yuqlid/EtherCAT_shield_v1/README.md

# EtherCAT_shield_v1
Nuleo64 EtherCAT Board

This board connect Nucleo64 to EtherCAT with LAN9252 controller chip.

Target Nucleo64 board
- NUCLEO-L476RG http://www.st.com/ja/evaluation-tools/nucleo-l476rg.html
- NUCLEO-F446RE http://www.st.com/ja/evaluation-tools/nucleo-f446re.html
