yuqlid/EtherCAT_shield_v1/EtherCAT_shield_v1.xlsx

Reference | Value | Footprint | Datasheet
R3 | 0 | Resistors_SMD:R_0603 | http://akizukidenshi.com/catalog/g/gR-11619/
R6 | 0 | Resistors_SMD:R_0603
R17 | 49.9 | Resistors_SMD:R_0603 | https://www.digikey.jp/product-detail/ja/yageo/RC0603FR-0749R9L/311-49.9HRCT-ND/730211
R16 | 49.9 | Resistors_SMD:R_0603
R15 | 49.9 | Resistors_SMD:R_0603
R14 | 49.9 | Resistors_SMD:R_0603
R11 | 49.9 | Resistors_SMD:R_0603
R10 | 49.9 | Resistors_SMD:R_0603
R9 | 49.9 | Resistors_SMD:R_0603
R8 | 49.9 | Resistors_SMD:R_0603
R5 | 330 | Resistors_SMD:R_0603 | https://www.digikey.jp/product-detail/ja/yageo/RC0603FR-07330RL/311-330HRCT-ND/730109 |  | 多分1kとかでもいい
R7 | 330 | Resistors_SMD:R_0603 |  |  | 多分1kとかでもいい
R22 | 330 | Resistors_SMD:R_0603 |  |  | 多分1kとかでもいい
R23 | 330 | Resistors_SMD:R_0603 |  |  | 多分1kとかでもいい
C2 | 0.022u | Capacitors_SMD:C_0603 | https://www.digikey.jp/product-detail/ja/samsung-electro-mechanics-america-inc/CL10B223KB8NNNC/1276-1104-1-ND/3889190
C3 | 0.022u | Capacitors_SMD:C_0603
C1 | 0.1u | Capacitors_SMD:C_0603 | http://akizukidenshi.com/catalog/g/gP-04940/
C18 | 0.1u | Capacitors_SMD:C_0603
C16 | 0.1u | Capacitors_SMD:C_0603
C4 | 0.1u | Capacitors_SMD:C_0603
C11 | 0.1u | Capacitors_SMD:C_0603
C17 | 0.1u | Capacitors_SMD:C_0603
C14 | 0.1u | Capacitors_SMD:C_0603
C15 | 0.1u | Capacitors_SMD:C_0603
C5 | 0.1u | Capacitors_SMD:C_0603
C6 | 0.1u | Capacitors_SMD:C_0603
C7 | 0.1u | Capacitors_SMD:C_0603
C8 | 0.1u | Capacitors_SMD:C_0603
C9 | 0.1u | Capacitors_SMD:C_0603
C10 | 0.1u | Capacitors_SMD:C_0603
C25 | 0.1u | Capacitors_SMD:C_0603
R4 | 10k | Resistors_SMD:R_0603 | 部室
R12 | 10k | Resistors_SMD:R_0603
R21 | 10k | Resistors_SMD:R_0603
R18 | 10k | Resistors_SMD:R_0603
R42 | 10k | Resistors_SMD:R_0603
R43 | 10k | Resistors_SMD:R_0603
R44 | 10k | Resistors_SMD:R_0603
C21 | 10p | Capacitors_SMD:C_0603 | https://www.digikey.jp/product-detail/ja/kemet/C0603C100J5GACTU/399-1049-1-ND/411324
C22 | 10p | Capacitors_SMD:C_0603
C23 | 10p | Capacitors_SMD:C_0603
C24 | 10p | Capacitors_SMD:C_0603
C26 | 10p | Capacitors_SMD:C_0603
C27 | 10p | Capacitors_SMD:C_0603
C28 | 10p | Capacitors_SMD:C_0603
C29 | 10p | Capacitors_SMD:C_0603
C31 | 10u | Capacitors_SMD:C_0805 | http://akizukidenshi.com/catalog/g/gP-07388/
C30 | 10u | Capacitors_SMD:C_0805
C33 | 10u | Capacitors_SMD:C_0805
C32 | 10u | Capacitors_SMD:C_0805
R13 | 12.1k | Resistors_SMD:R_0603 | https://www.digikey.jp/product-detail/ja/yageo/RC0603FR-0712K1L/311-12.1KHRCT-ND/729862
R24 | 1k | Resistors_SMD:R_0603 | https://www.digikey.jp/product-detail/ja/yageo/RC0603JR-071KL/311-1.0KGRCT-ND/729624
R25 | 1k | Resistors_SMD:R_0603
R26 | 1k | Resistors_SMD:R_0603
R27 | 1k | Resistors_SMD:R_0603
R28 | 1k | Resistors_SMD:R_0603
R29 | 1k | Resistors_SMD:R_0603
R30 | 1k | Resistors_SMD:R_0603
R31 | 1k | Resistors_SMD:R_0603
R32 | 1k | Resistors_SMD:R_0603
R33 | 1k | Resistors_SMD:R_0603
R34 | 1k | Resistors_SMD:R_0603
R35 | 1k | Resistors_SMD:R_0603
R36 | 1k | Resistors_SMD:R_0603
R37 | 1k | Resistors_SMD:R_0603
R38 | 1k | Resistors_SMD:R_0603
R39 | 1k | Resistors_SMD:R_0603
C12 | 1u | Capacitors_SMD:C_0603 | http://akizukidenshi.com/catalog/g/gP-09633/
U2 | 24LC00 | Housings_DIP:DIP-8_W7.62mm_Socket_LongPads | http://akizukidenshi.com/catalog/g/gI-03569/ | http://akizukidenshi.com/catalog/g/gP-00035/
R19 | 2k | Resistors_SMD:R_0603 |  |  | 多分4.7kとかでもいい
R20 | 2k | Resistors_SMD:R_0603 |  |  | 多分4.7kとかでもいい
R45 | 4.7k | Resistors_SMD:R_0603 |  |  | 多分10kとかでもいい
C13 | 470p | Capacitors_SMD:C_0603 | https://www.digikey.jp/product-detail/ja/samsung-electro-mechanics-america-inc/CL10C471JB8NNNC/1276-1168-1-ND/3889254 | http://akizukidenshi.com/catalog/g/gP-09268/
C19 | C | Capacitors_SMD:C_0603 | https://www.digikey.jp/product-detail/ja/kemet/C0603C100J5GACTU/399-1049-1-ND/411324
C20 | C | Capacitors_SMD:C_0603
P1 | CONN_02X10 | Socket_Strips:Socket_Strip_Straight_2x10_Pitch2.54mm | http://akizukidenshi.com/catalog/g/gC-00083/
P2 | CONN_02X19 | Pin_Headers:Pin_Header_Straight_2x19_Pitch2.54mm | http://www.digikey.jp/product-detail/ja/samtec-inc/ESQ-119-24-T-D/SAM9313-ND/6678050 |  | たっか，なんか他のでどうにかしたい
P3 | CONN_02X19 | Pin_Headers:Pin_Header_Straight_2x19_Pitch2.54mm
Y1 | Crystal_GND24 | Crystals:Crystal_SMD_Abracon_ABM8G-4pin_3.2x2.5mm | https://www.digikey.jp/product-detail/ja/abracon-llc/ABM8-25.000MHZ-10-D1G-T/535-13468-1-ND/5980144
J7 | GS2 | Connect:GS2
J8 | GS2 | Connect:GS2
J5 | GS3 | Connect:GS3
J6 | GS3 | Connect:GS3
J4 | GS3 | Connect:GS3
J3 | GS3 | Connect:GS3
L4 | L | Capacitors_SMD:C_0603 | https://www.digikey.jp/products/ja?keywords=%09490-5255-1-ND
L1 | L | Capacitors_SMD:C_0603
L2 | L | Capacitors_SMD:C_0603
L3 | L | Capacitors_SMD:C_0603
U1 | LAN9252 | Housings_DFN_QFN:QFN-64-1EP_9x9mm_Pitch0.5mm | https://www.digikey.jp/product-detail/ja/microchip-technology/LAN9252-ML/LAN9252-ML-ND/5252338
D1 | LED | LEDs:LED_0603 | http://akizukidenshi.com/catalog/g/gI-03980/
D2 | LED | LEDs:LED_0603
D3 | LED | LEDs:LED_0603
D4 | LED | LEDs:LED_0603
D5 | LED | LEDs:LED_0603
D6 | LED | LEDs:LED_0603
D7 | LED | LEDs:LED_0603
D8 | LED | LEDs:LED_0603
D9 | LED | LEDs:LED_0603
D10 | LED | LEDs:LED_0603
D11 | LED | LEDs:LED_0603
D12 | LED | LEDs:LED_0603
D13 | LED | LEDs:LED_0603
D14 | LED | LEDs:LED_0603
D15 | LED | LEDs:LED_0603
D16 | LED | LEDs:LED_0603
D17 | LED | LEDs:LED_0603
D18 | LED | LEDs:LED_0603
R1 | R | Resistors_SMD:R_0603 |  |  | 多分1kとかでもいい
R2 | R | Resistors_SMD:R_0603 |  |  | 多分1kとかでもいい
R40 | R | Resistors_SMD:R_1210
R41 | R | Resistors_SMD:R_1210
J2 | RJ45-PULSETRANS | Connect:RJ45_J0011D21BNL | http://akizukidenshi.com/catalog/g/gP-04809/ | http://akizukidenshi.com/catalog/g/gP-00819/
J1 | RJ45-PULSETRANS | Connect:RJ45_J0011D21BNL
