yuqlid/EtherCAT_shield_v1/EtherCAT_shield_v1.pdf

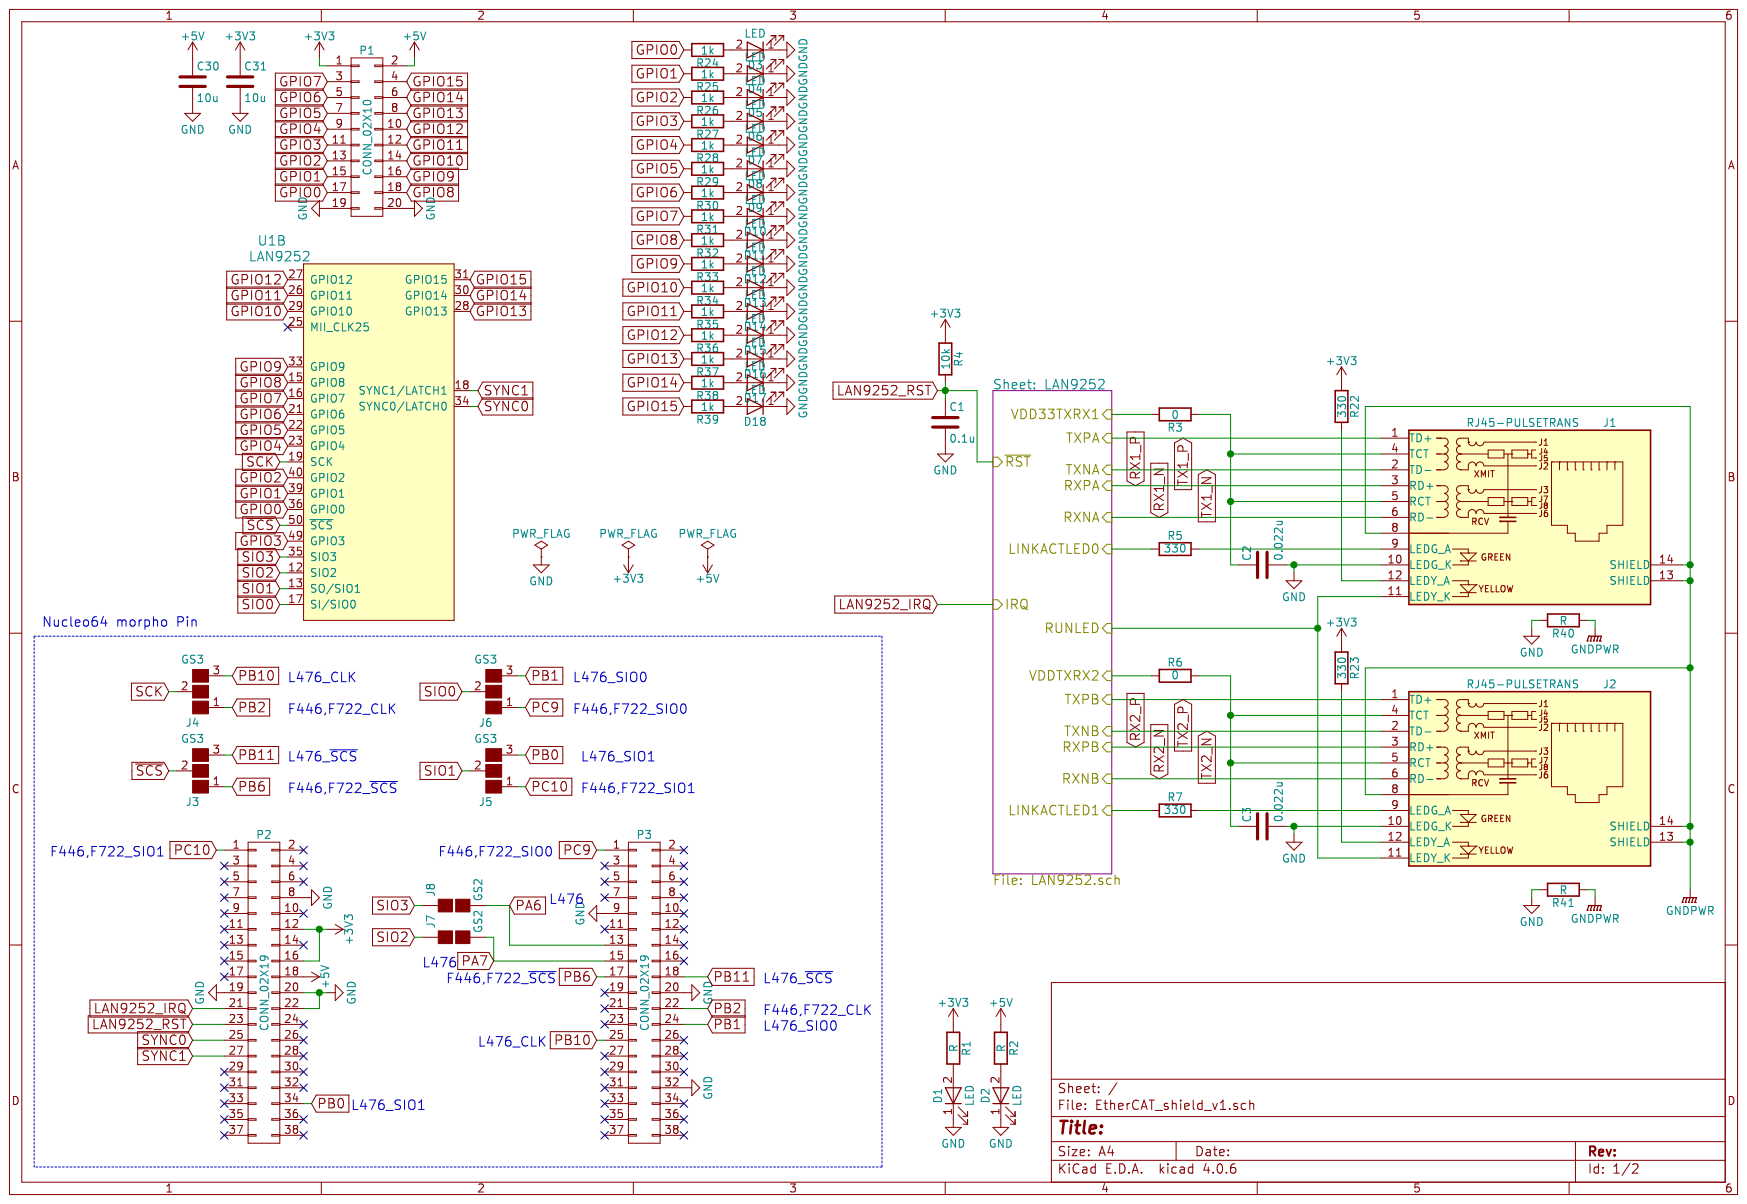
[picture p1: page 1]

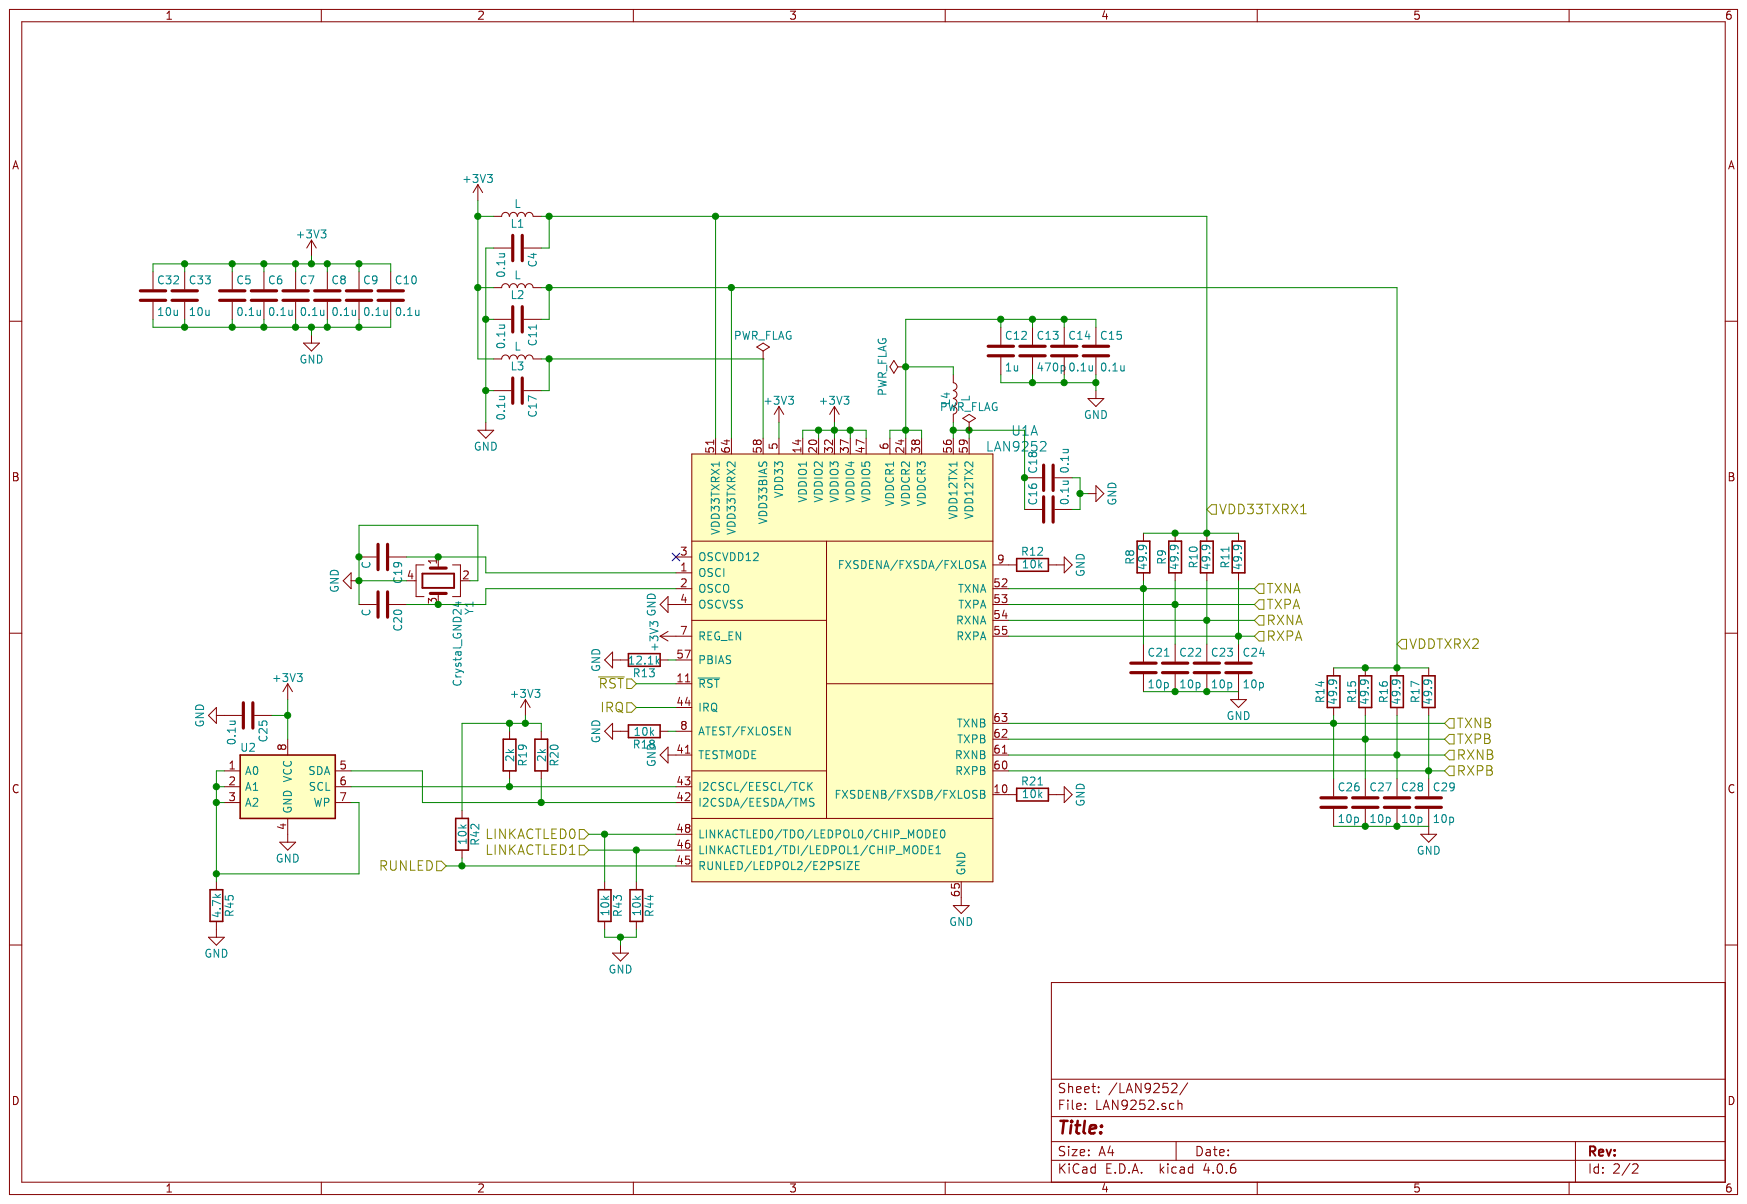
[picture p2: page 2]
