yuqlid/EtherCAT_shield_v1/EtherCAT_shield_v1.kicad_pcb

## KiCad design EtherCAT_shield_v1.kicad_pcb (2017-06-03)

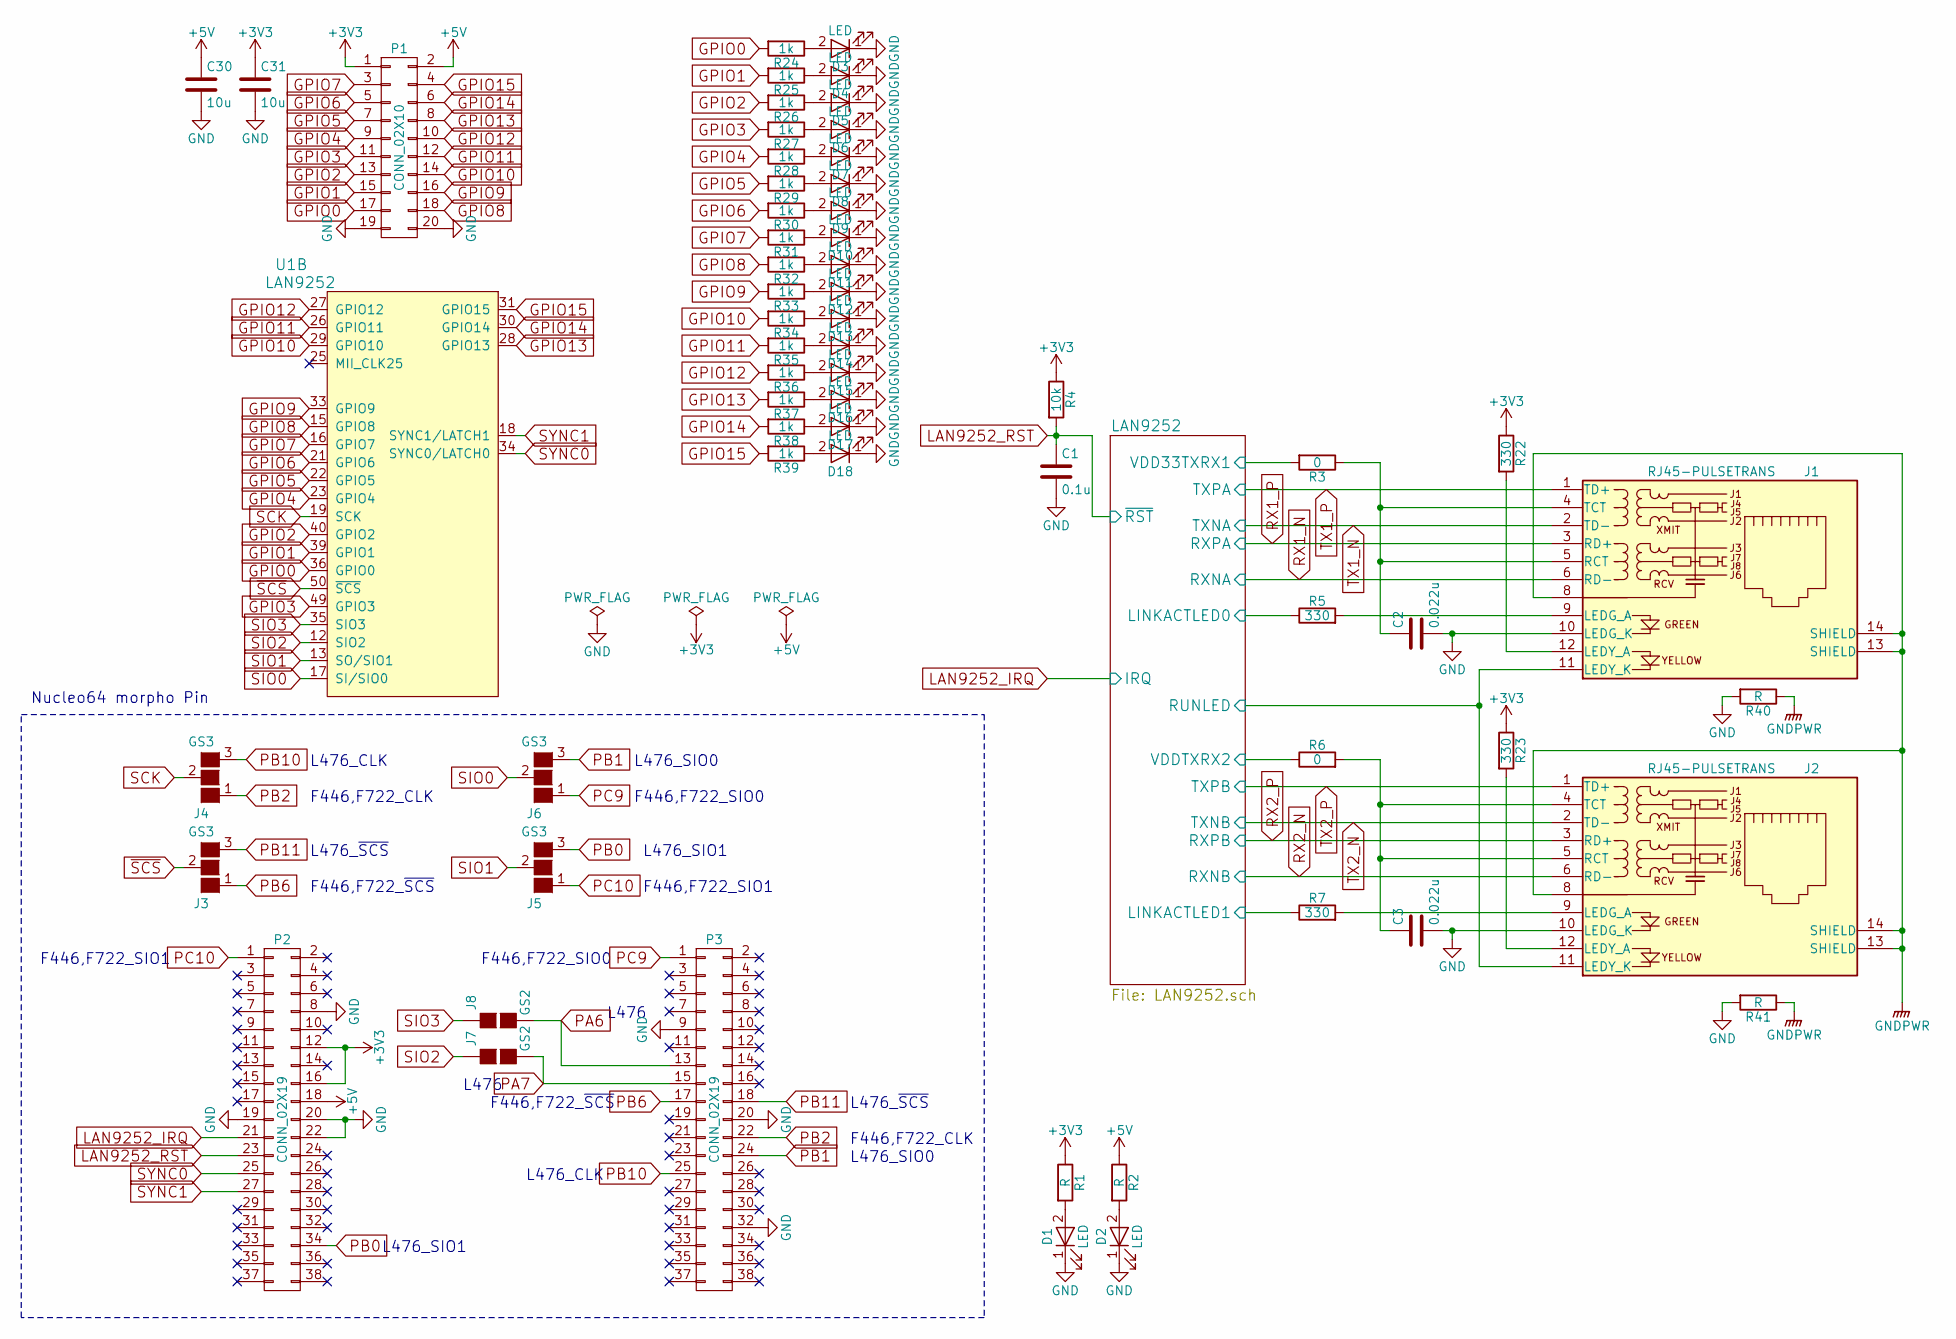
[picture p3: schematic EtherCAT_shield_v1.sch]

Parts:
C1: 0.1u; C_0603
C2, C3: 0.022u; C_0603
C30, C31: 10u; C_0805
D1, D2, D3, D4, D5, D6, D7, D8, D9, D10, D11, D12, D13, D14, D15, D16, D17, D18: LED; LED_0603
J1, J2: RJ45-PULSETRANS; RJ45_J0011D21BNL
J3, J4, J5, J6: GS3
J7, J8: GS2
P1: CONN_02X10; Socket_Strip_Straight_2x10_Pitch2.54mm
P2, P3: CONN_02X19; Pin_Header_Straight_2x19_Pitch2.54mm
R1, R2: R; R_0603
R3, R6: 0; R_0603
R4: 10k; R_0603
R5, R7, R22, R23: 330; R_0603
R24, R25, R26, R27, R28, R29, R30, R31, R32, R33, R34, R35, R36, R37, R38, R39: 1k; R_0603
R40, R41: R; R_1210
U1: LAN9252; QFN-64-1EP_9x9mm_Pitch0.5mm

Connections:
+3V3: C31.1, P1.1, P2.12, P2.16, R1.1, R4.1, R22.1, R23.1; also elsewhere on the board
+5V: C30.1, P1.2, P2.18, R2.1
/LAN9252/LINKACTLED0: R5.1; also elsewhere on the board
/LAN9252/LINKACTLED1: R7.1; also elsewhere on the board
/LAN9252/RUNLED: J1.11 (LEDY_K), J2.11 (LEDY_K); also elsewhere on the board
/LAN9252/VDD33TXRX1: R3.2; also elsewhere on the board
/LAN9252/VDDTXRX2: R6.1; also elsewhere on the board
GND: C1.2, C2.2, C3.2, C30.2, C31.2, D1.1 (K), D2.1 (K), D3.1 (K), D4.1 (K), D5.1 (K), D6.1 (K), D7.1 (K), D8.1 (K), D9.1 (K), D10.1 (K), D11.1 (K), D12.1 (K), D13.1 (K), D14.1 (K), D15.1 (K), D16.1 (K), D17.1 (K), D18.1 (K), J1.10 (LEDG_K), J2.10 (LEDG_K), P1.19, P1.20, P2.8, P2.19, P2.20, P2.22, P3.9, P3.20, P3.32, R40.2, R41.2; also elsewhere on the board
GNDPWR: J1.8, J1.13 (SHIELD), J1.14 (SHIELD), J2.8, J2.13 (SHIELD), J2.14 (SHIELD), R40.1, R41.1
GPIO0: P1.17, R24.2, U1.36 (GPIO0)
GPIO1: P1.15, R25.2, U1.39 (GPIO1)
GPIO2: P1.13, R26.2, U1.40 (GPIO2)
GPIO3: P1.11, R27.2, U1.49 (GPIO3)
GPIO4: P1.9, R28.2, U1.23 (GPIO4)
GPIO5: P1.7, R29.2, U1.22 (GPIO5)
GPIO6: P1.5, R30.2, U1.21 (GPIO6)
GPIO7: P1.3, R31.2, U1.16 (GPIO7)
GPIO8: P1.18, R32.2, U1.15 (GPIO8)
GPIO9: P1.16, R33.2, U1.33 (GPIO9)
GPIO10: P1.14, R34.2, U1.29 (GPIO10)
GPIO11: P1.12, R35.2, U1.26 (GPIO11)
GPIO12: P1.10, R36.2, U1.27 (GPIO12)
GPIO13: P1.8, R37.2, U1.28 (GPIO13)
GPIO14: P1.6, R38.2, U1.30 (GPIO14)
GPIO15: P1.4, R39.2, U1.31 (GPIO15)
LAN9252_IRQ: P2.21; also elsewhere on the board
LAN9252_RST: C1.1, P2.23, R4.2; also elsewhere on the board
unnamed: C2.1, J1.4 (TCT), J1.5 (RCT), R3.1
unnamed: C3.1, J2.4 (TCT), J2.5 (RCT), R6.2
unnamed: D1.2 (A), R1.2
unnamed: D2.2 (A), R2.2
unnamed: D3.2 (A), R24.1
unnamed: D4.2 (A), R25.1
unnamed: D5.2 (A), R26.1
unnamed: D6.2 (A), R27.1
unnamed: D7.2 (A), R28.1
unnamed: D8.2 (A), R29.1
unnamed: D9.2 (A), R30.1
unnamed: D10.2 (A), R31.1
unnamed: D11.2 (A), R32.1
unnamed: D12.2 (A), R33.1
unnamed: D13.2 (A), R34.1
unnamed: D14.2 (A), R35.1
unnamed: D15.2 (A), R36.1
unnamed: D16.2 (A), R37.1
unnamed: D17.2 (A), R38.1
unnamed: D18.2 (A), R39.1
unnamed: J1.9 (LEDG_A), R5.2
unnamed: J1.12 (LEDY_A), R22.2
unnamed: J2.9 (LEDG_A), R7.2
unnamed: J2.12 (LEDY_A), R23.2
PA6: J8.2 (G2), P3.13
PA7: J7.2 (G2), P3.15
PB0: J5.3 (G3), P2.34
PB1: J6.3 (G3), P3.24
PB2: J4.1 (G1), P3.22
PB6: J3.1 (G1), P3.17
PB10: J4.3 (G3), P3.25
PB11: J3.3 (G3), P3.18
PC9: J6.1 (G1), P3.1
PC10: J5.1 (G1), P2.1
RX1_N: J1.6 (RD-); also elsewhere on the board
RX1_P: J1.3 (RD+); also elsewhere on the board
RX2_N: J2.6 (RD-); also elsewhere on the board
RX2_P: J2.3 (RD+); also elsewhere on the board
SCK: J4.2 (G2), U1.19 (SCK)
SIO0: J6.2 (G2), U1.17 (SI/SIO0)
SIO1: J5.2 (G2), U1.13 (SO/SIO1)
SIO2: J7.1 (G1), U1.12 (SIO2)
SIO3: J8.1 (G1), U1.35 (SIO3)
SYNC0: P2.25, U1.34 (SYNC0/LATCH0)
SYNC1: P2.27, U1.18 (SYNC1/LATCH1)
TX1_N: J1.2 (TD-); also elsewhere on the board
TX1_P: J1.1 (TD+); also elsewhere on the board
TX2_N: J2.2 (TD-); also elsewhere on the board
TX2_P: J2.1 (TD+); also elsewhere on the board
~SCS: J3.2 (G2), U1.50 (~SCS)

Notes on the sheet:
F446,F722_~SCS
L476_CLK
L476
L476_SIO1
F446,F722_SIO1
F446,F722_CLK
L476_~SCS
L476_SIO0
F446,F722_SIO0
Nucleo64 morpho Pin

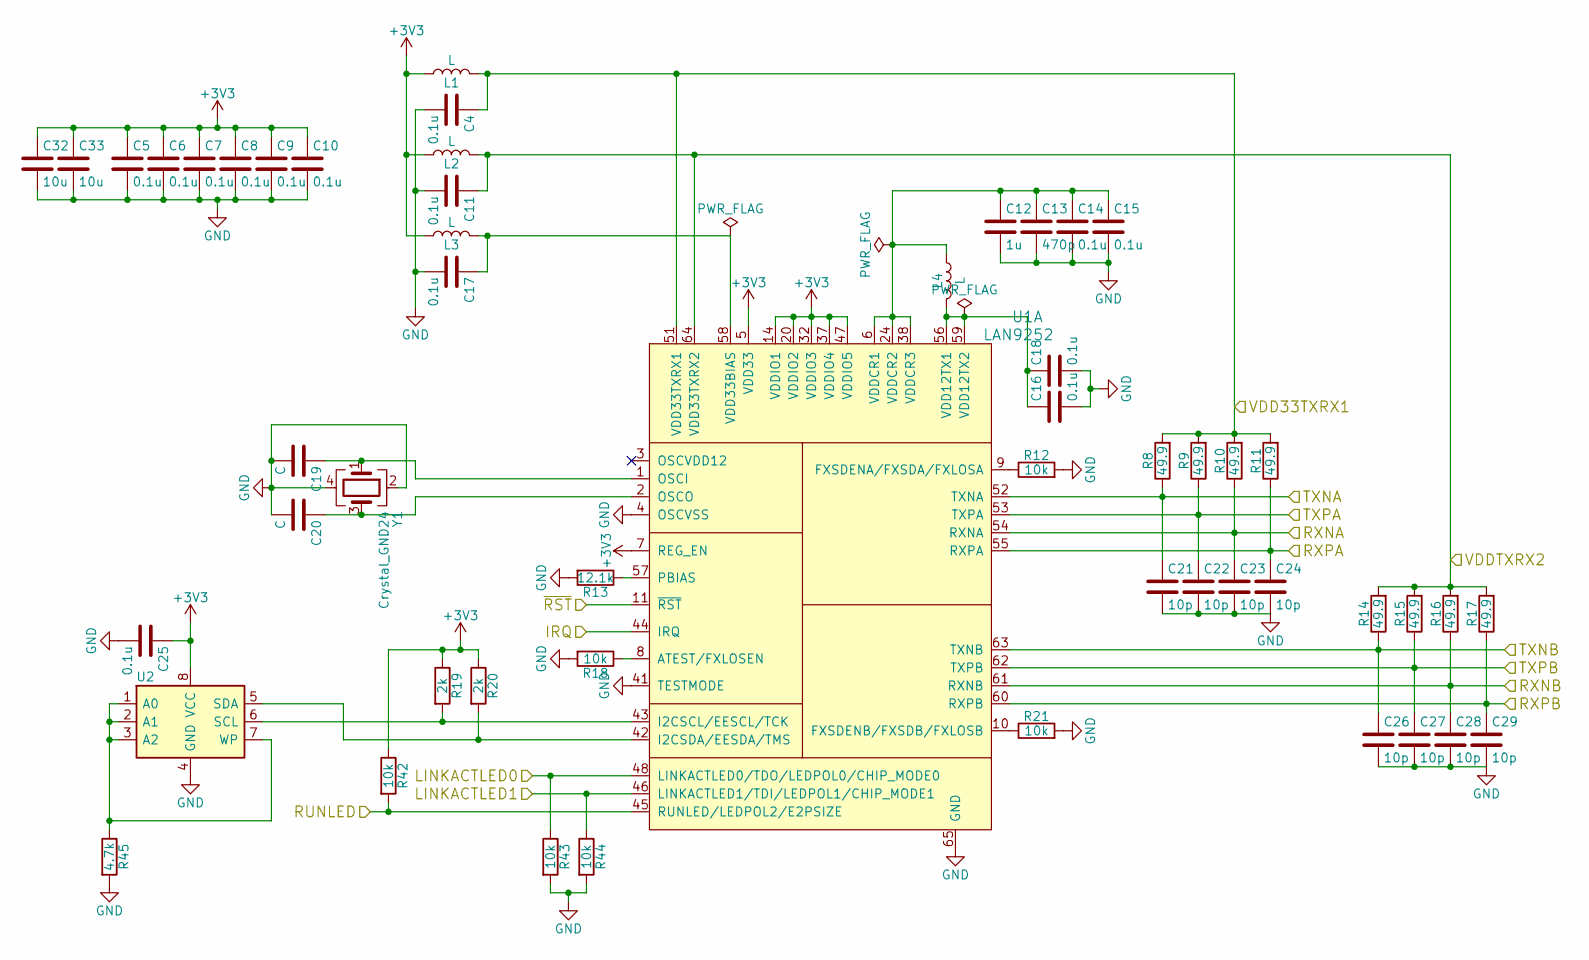
[picture p4: schematic LAN9252.sch]

Parts:
C4, C5, C6, C7, C8, C9, C10, C11, C14, C15, C16, C17, C18, C25: 0.1u; C_0603
C12: 1u; C_0603
C13: 470p; C_0603
C19, C20: C; C_0603
C21, C22, C23, C24, C26, C27, C28, C29: 10p; C_0603
C32, C33: 10u; C_0805
L1, L2, L3, L4: L; C_0603
R8, R9, R10, R11, R14, R15, R16, R17: 49.9; R_0603
R12, R18, R21, R42, R43, R44: 10k; R_0603
R13: 12.1k; R_0603
R19, R20: 2k; R_0603
R45: 4.7k; R_0603
U1: LAN9252; QFN-64-1EP_9x9mm_Pitch0.5mm
U2: 24LC00; DIP-8_W7.62mm_Socket_LongPads
Y1: Crystal_GND24; Crystal_SMD_Abracon_ABM8G-4pin_3.2x2.5mm

Connections:
+3V3: C5.1, C6.1, C7.1, C8.1, C9.1, C10.1, C25.1, C32.1, C33.1, L1.1, L2.1, L3.1, R19.1, R20.1, R42.1, U1.5 (VDD33), U1.7 (REG_EN), U1.14 (VDDIO1), U1.20 (VDDIO2), U1.32 (VDDIO3), U1.37 (VDDIO4), U1.47 (VDDIO5), U2.8 (VCC); also elsewhere on the board
/LAN9252/LINKACTLED0: R43.1, U1.48 (LINKACTLED0/TDO/LEDPOL0/CHIP_MODE0); also elsewhere on the board
/LAN9252/LINKACTLED1: R44.1, U1.46 (LINKACTLED1/TDI/LEDPOL1/CHIP_MODE1); also elsewhere on the board
/LAN9252/RUNLED: R42.2, U1.45 (RUNLED/LEDPOL2/E2PSIZE); also elsewhere on the board
/LAN9252/VDD33TXRX1: C4.1, L1.2, R8.2, R9.2, R10.2, R11.2, U1.51 (VDD33TXRX1); also elsewhere on the board
/LAN9252/VDDTXRX2: C11.1, L2.2, R14.2, R15.2, R16.2, R17.2, U1.64 (VDD33TXRX2); also elsewhere on the board
GND: C4.2, C5.2, C6.2, C7.2, C8.2, C9.2, C10.2, C11.2, C12.2, C13.2, C14.2, C15.2, C16.2, C17.2, C18.2, C19.2, C20.2, C21.2, C22.2, C23.2, C24.2, C25.2, C26.2, C27.2, C28.2, C29.2, C32.2, C33.2, R12.2, R13.2, R18.2, R21.2, R43.2, R44.2, R45.2, U1.4 (OSCVSS), U1.41 (TESTMODE), U1.65 (GND), U2.4 (GND), Y1.2, Y1.4; also elsewhere on the board
LAN9252_IRQ: U1.44 (IRQ); also elsewhere on the board
LAN9252_RST: U1.11 (~RST); also elsewhere on the board
unnamed: C12.1, C13.1, C14.1, C15.1, L4.1, U1.6 (VDDCR1), U1.24 (VDDCR2), U1.38 (VDDCR3)
unnamed: C16.1, C18.1, L4.2, U1.56 (VDD12TX1), U1.59 (VDD12TX2)
unnamed: C17.1, L3.2, U1.58 (VDD33BIAS)
unnamed: C19.1, U1.1 (OSCI), Y1.1
unnamed: C20.1, U1.2 (OSCO), Y1.3
unnamed: R12.1, U1.9 (FXSDENA/FXSDA/FXLOSA)
unnamed: R13.1, U1.57 (PBIAS)
unnamed: R18.1, U1.8 (ATEST/FXLOSEN)
unnamed: R19.2, U1.43 (I2CSCL/EESCL/TCK), U2.6 (SCL)
unnamed: R20.2, U1.42 (I2CSDA/EESDA/TMS), U2.5 (SDA)
unnamed: R21.1, U1.10 (FXSDENB/FXSDB/FXLOSB)
unnamed: R45.1, U2.1 (A0), U2.2 (A1), U2.3 (A2), U2.7 (WP)
RX1_N: C23.1, R10.1, U1.54 (RXNA); also elsewhere on the board
RX1_P: C24.1, R11.1, U1.55 (RXPA); also elsewhere on the board
RX2_N: C28.1, R16.1, U1.61 (RXNB); also elsewhere on the board
RX2_P: C29.1, R17.1, U1.60 (RXPB); also elsewhere on the board
TX1_N: C21.1, R8.1, U1.52 (TXNA); also elsewhere on the board
TX1_P: C22.1, R9.1, U1.53 (TXPA); also elsewhere on the board
TX2_N: C26.1, R14.1, U1.63 (TXNB); also elsewhere on the board
TX2_P: C27.1, R15.1, U1.62 (TXPB); also elsewhere on the board

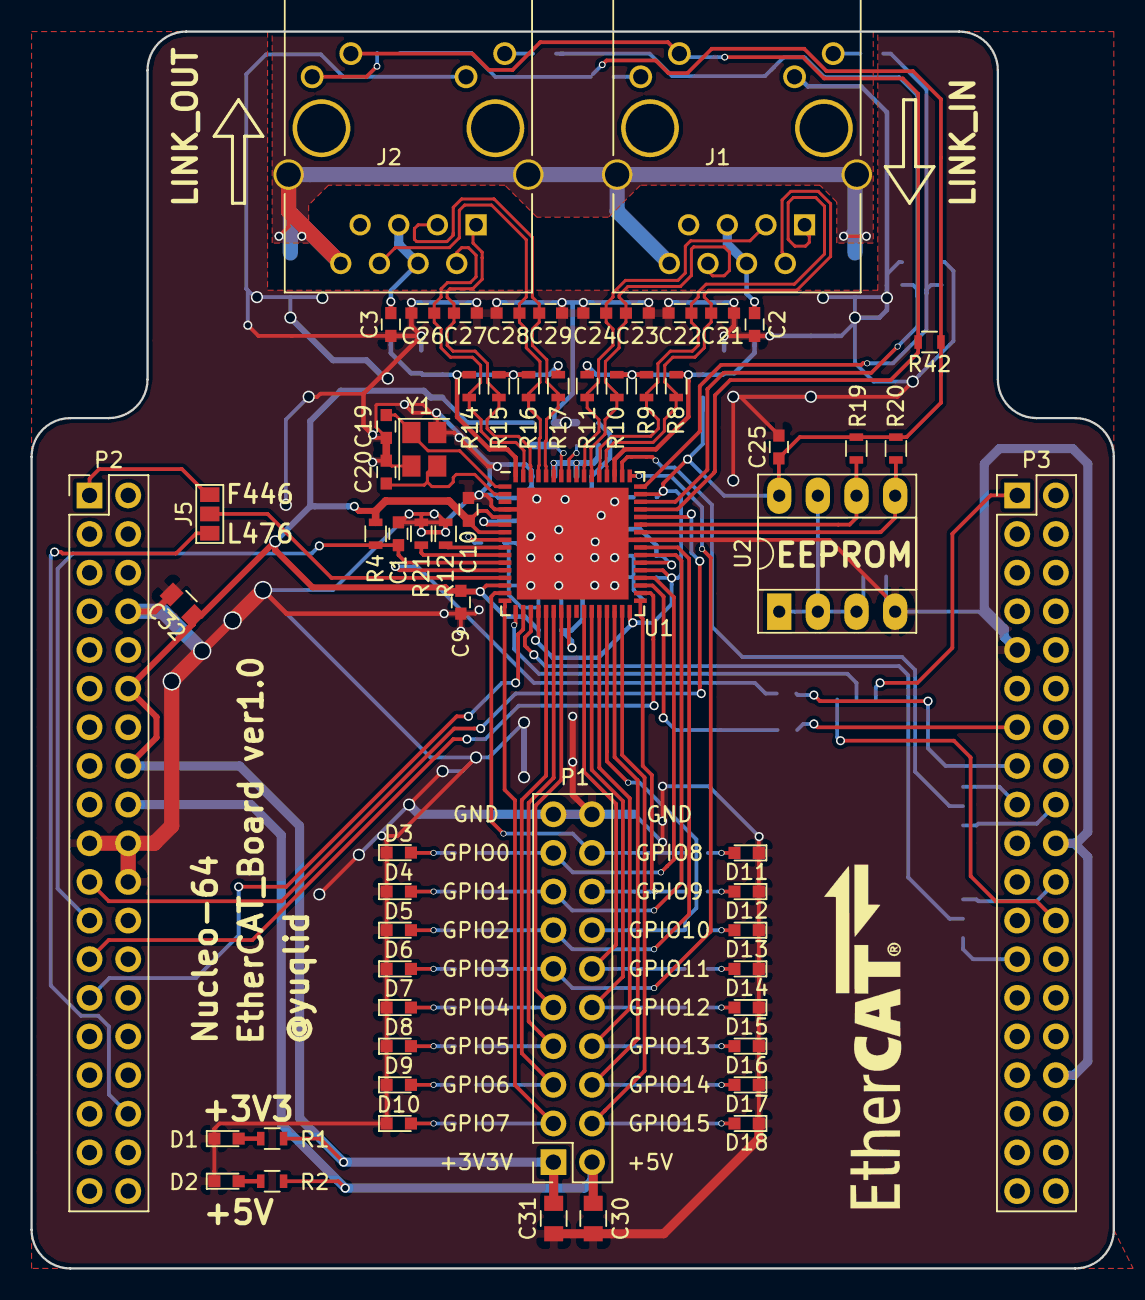
[picture p5: board EtherCAT_shield_v1.kicad_pcb from above]

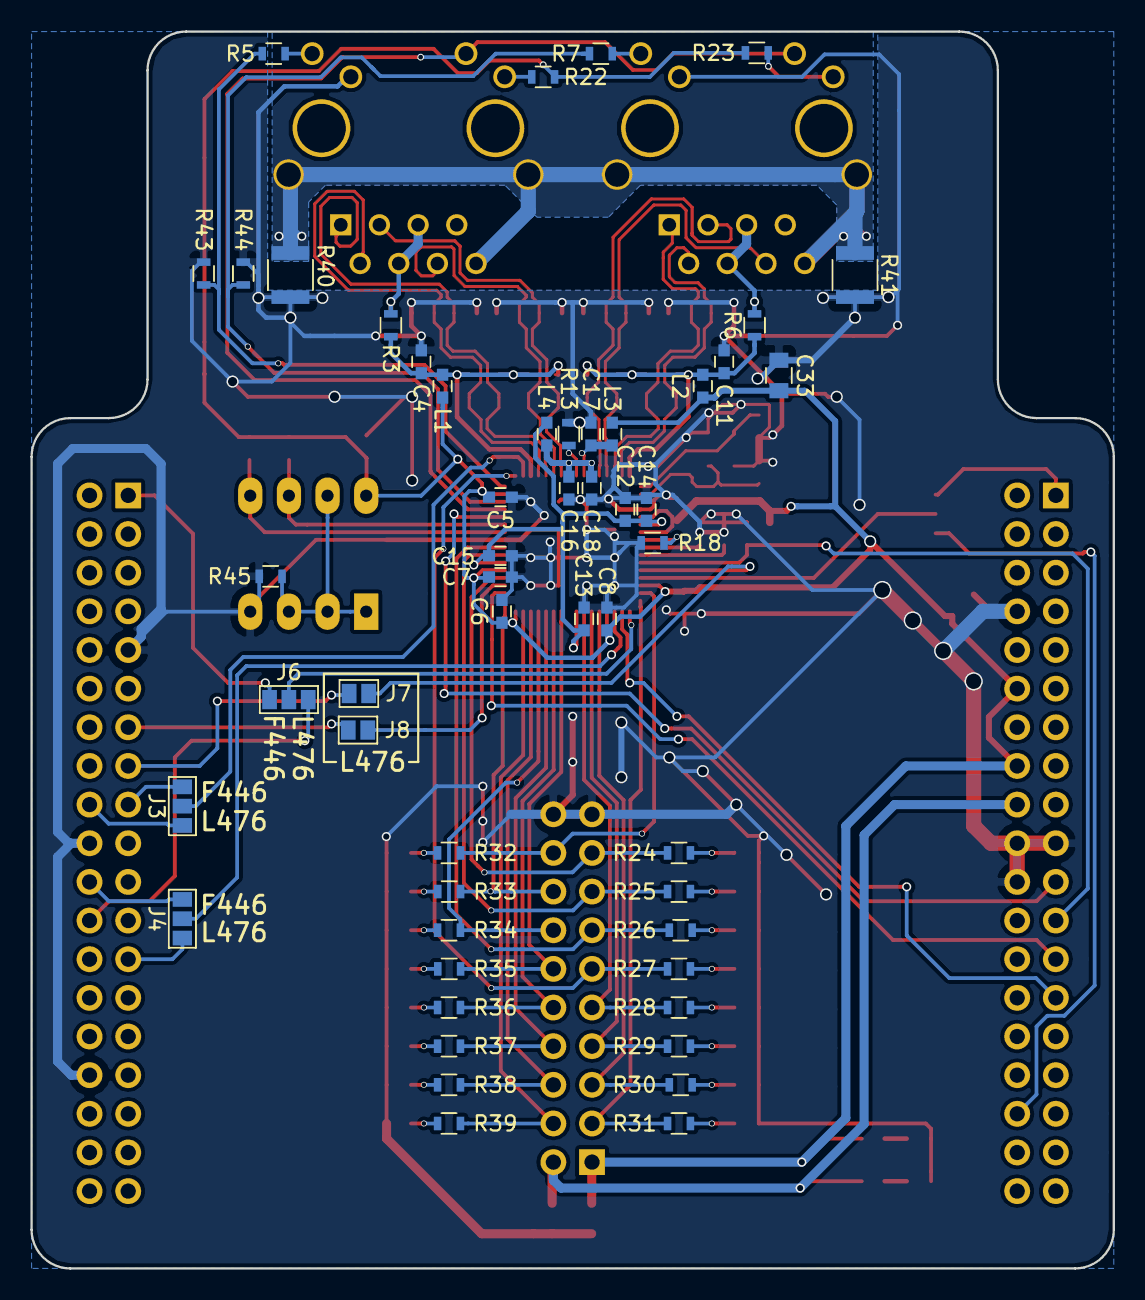
[picture p6: board EtherCAT_shield_v1.kicad_pcb from below]

Board: 2 copper layers, 71.1 x 81.3 mm, 114 parts (52 on the bottom side), 89 nets.
