yuqlid/EtherCAT_shield_v1/(commit log)

2017-03-27 部品修正．一度アノテーションとネットリスト生成
    [EtherCAT_shield_v1.kicad_pcb, EtherCAT_shield_v1.sch, LAN9252.sch]
2017-03-28 ピンソケットの位置合わせ
    [EtherCAT_shield_v1.kicad_pcb]
2017-03-28 適当に外形起こした
    [EtherCAT_shield_v1.kicad_pcb]
2017-03-28 部品変更，再アノテーション，コネクタだけ配置
    [EtherCAT_shield_v1.kicad_pcb, EtherCAT_shield_v1.sch, LAN9252.sch]
2017-03-29 差動線修正
    [EtherCAT_shield_v1.kicad_pcb]
2017-03-29 LINK方向の矢印追加
    [EtherCAT_shield_v1.kicad_pcb]
2017-03-29 画像はりたい
    [EtherCAT_shield_v1.kicad_pcb]
2017-03-29 ロゴ追加した
    [EtherCAT_shield_v1.kicad_pcb]
2017-03-30 LED変更，再アノテーション
    [EtherCAT_shield_v1.kicad_pcb, EtherCAT_shield_v1.sch, LAN9252.sch]
2017-04-02 GPIOのLED並べた 実質完成
    [EtherCAT_shield_v1.kicad_pcb, EtherCAT_shield_v1.sch, LAN9252.sch]
2017-04-02 外形を変更
    [EtherCAT_shield_v1.kicad_pcb, EtherCAT_shield_v1.sch]
2017-04-02 外形線を変更
    [EtherCAT_shield_v1.kicad_pcb, EtherCAT_shield_v1.sch, LAN9252.sch]
2017-04-02 回路図を整理した
    [EtherCAT_shield_v1.kicad_pcb, EtherCAT_shield_v1.sch]
2017-04-03 外形寸法を書いた
    [EtherCAT_shield_v1.kicad_pcb]
2017-04-03 CHS GNDとPCB GNDを抵抗で接続
    [EtherCAT_shield_v1.kicad_pcb, EtherCAT_shield_v1.sch, LAN9252.sch]
2017-04-03 GNDまわりの調整
    [EtherCAT_shield_v1.kicad_pcb]
2017-04-03 抵抗とかコンデンサを追加
    [EtherCAT_shield_v1.kicad_pcb, EtherCAT_shield_v1.sch, LAN9252.sch]
2017-04-06 viaの調整
    [EtherCAT_shield_v1.kicad_pcb, LAN9252.sch]
2017-04-06 このデータで発注します
    [EtherCAT_shield_v1-B.Cu.gbr, EtherCAT_shield_v1-B.SilkS.gbr, EtherCAT_shield_v1-Edge.Cuts.gbr, EtherCAT_shield_v1-F.Cu.gbr, EtherCAT_shield_v1-F.SilkS.gbr, EtherCAT_shield_v1.drl]
2017-04-06 ドリルデータをミスってた＆マスク出し忘れてたのでこっちで発注
    [EtherCAT_shield_v1-B.Cu.gbr, EtherCAT_shield_v1-B.Mask.gbr, EtherCAT_shield_v1-B.SilkS.gbr, EtherCAT_shield_v1-Edge.Cuts.gbr, EtherCAT_shield_v1-F.Cu.gbr, EtherCAT_shield_v1-F.Mask.gbr, EtherCAT_shield_v1-F.SilkS.gbr, EtherCAT_shield_v1.drl]
2017-04-07 値ふってBOM作成
    [EtherCAT_shield_v1.sch, EtherCAT_shield_v1.xlsx, LAN9252.sch]
2017-04-08 BOM更新
    [EtherCAT_shield_v1.xlsx]
2017-04-23 C16が未接続だったので修正
    [EtherCAT_shield_v1.kicad_pcb]
2017-04-23 C11のシルクの位置を修正
    [EtherCAT_shield_v1.kicad_pcb]
2017-04-23 LINK_IN,LINK_OUTの向きを修正
    [EtherCAT_shield_v1.kicad_pcb]
2017-05-11 部品のURLを修正
    [EtherCAT_shield_v1.xlsx]
2017-05-12 不要な製造ファイルを削除
    [EtherCAT_shield_v1-B.Cu.gbr, EtherCAT_shield_v1-B.Mask.gbr, EtherCAT_shield_v1-B.SilkS.gbr, EtherCAT_shield_v1-Edge.Cuts.gbr, EtherCAT_shield_v1-F.Cu.gbr, EtherCAT_shield_v1-F.Mask.gbr, EtherCAT_shield_v1-F.SilkS.gbr]
2017-05-18 PDF追加
2017-06-03 RJ45コネクタののLED向きを修正
    [EtherCAT_shield_v1.kicad_pcb, EtherCAT_shield_v1.sch, LAN9252.sch]
2017-06-03 pdf回路図を更新
